CoalTrain59/CandleStick/CandleStick_Board_Rev1/HelpLinks.txt

https://www.circuitbasics.com/arduino-thermistor-temperature-sensor-tutorial/
