CoalTrain59/CandleStick/CandleBurner/BOM.txt

ID	Name	Quantity	Manufacturer Part	Manufacturer	Supplier	Supplier Part	Price
1	100Ω	1	201007F1000T4E	Uniroyal Elec	LCSC	C421954	0.024
2	VA05-V2S12	1	VA05-V2S12	GTL-POWER	LCSC	C341500	5.303
3	DB128L-5.0-2P-BK-S	2	DB128L-5.0-2P-BK-S	DIBO	LCSC	C430597	0.136
4	KH-A2541WV-6P	1	KH-A2541WV-6P	kinghelm(金航标)	LCSC	C2833331	0.141
5	0.47uF	3	KMR47M050C110A	Capxon International Elec	LCSC	C244347	0.021
6	KH-A2541WV-10P	1	KH-A2541WV-10P	kinghelm(金航标)	LCSC	C2833333	0.229
7	220S-1*8P H=8.5MM Ytype Gold-plated	1	220S-1*8P H=8.5MM Ytype Gold-plated	Ckmtw	LCSC	C124416	0.13
8	TLP521-1XSM	1	TLP521-1XSM	ISOCOM	LCSC	C83157	0.174
9	KH-A2541WV-8P	2	KH-A2541WV-8P	kinghelm(金航标)	LCSC	C2833332	0.183
10	1kΩ	7	RT2010BKE071KL	YAGEO	LCSC	C706458	0.105
11	10kΩ	1	201007F1002T4E	Uniroyal Elec	LCSC	C421952	0.024
12	DB107S_C5377	1	DB107S	MDD	LCSC	C5377	0.064
13	220S-2*3P H=8.5MM Ytype Gold-plated	1	220S-2*3P H=8.5MM Ytype Gold-plated	Ckmtw	LCSC	C124421	0.113
14	BTA08-600CRG	1	BTA08-600CRG	STMicroelectronics	LCSC	C9102	0.83
15	MOC3020	1	MOC3020	LITEON	LCSC	C115463	0.191
