CoalTrain59/CandleStick/Enclosure/MainLid.stl

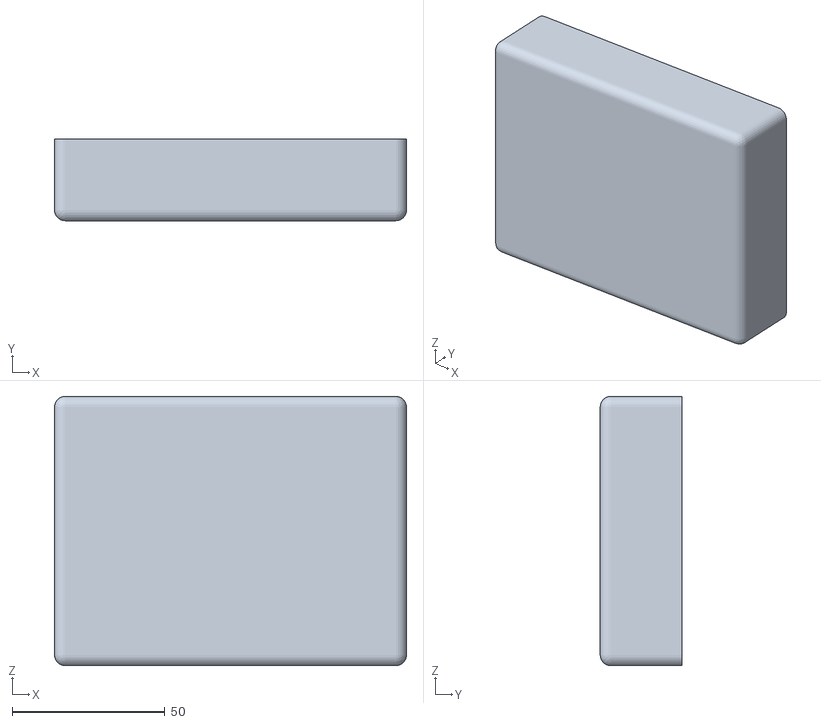
[picture p1: CAD file, 2022-04-02]
Enclosure/MainLid.stl
115.4 x 26.8 x 88.3
