CoalTrain59/CandleStick/Enclosure/CandleBurnerEnclosure.FCStd

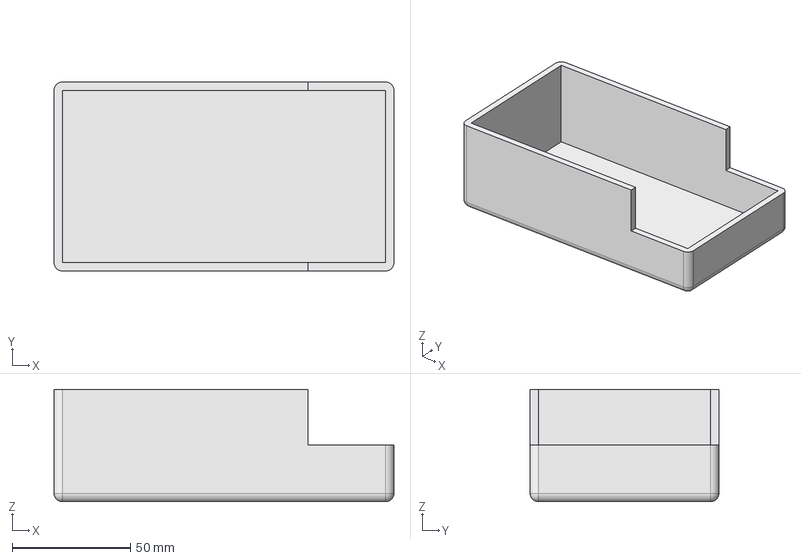
[picture p2: CAD file, 2022-04-02]
Enclosure/CandleBurnerEnclosure.FCStd
144.0 x 80.0 x 47.5 mm
