CoalTrain59/CandleStick/(list of files, cad)

Other CAD files:
Enclosure/CandleBurnerLid.FCStd
Enclosure/Enclosure1.stl
