CoalTrain59/CandleStick/PID Tuning/Best.png

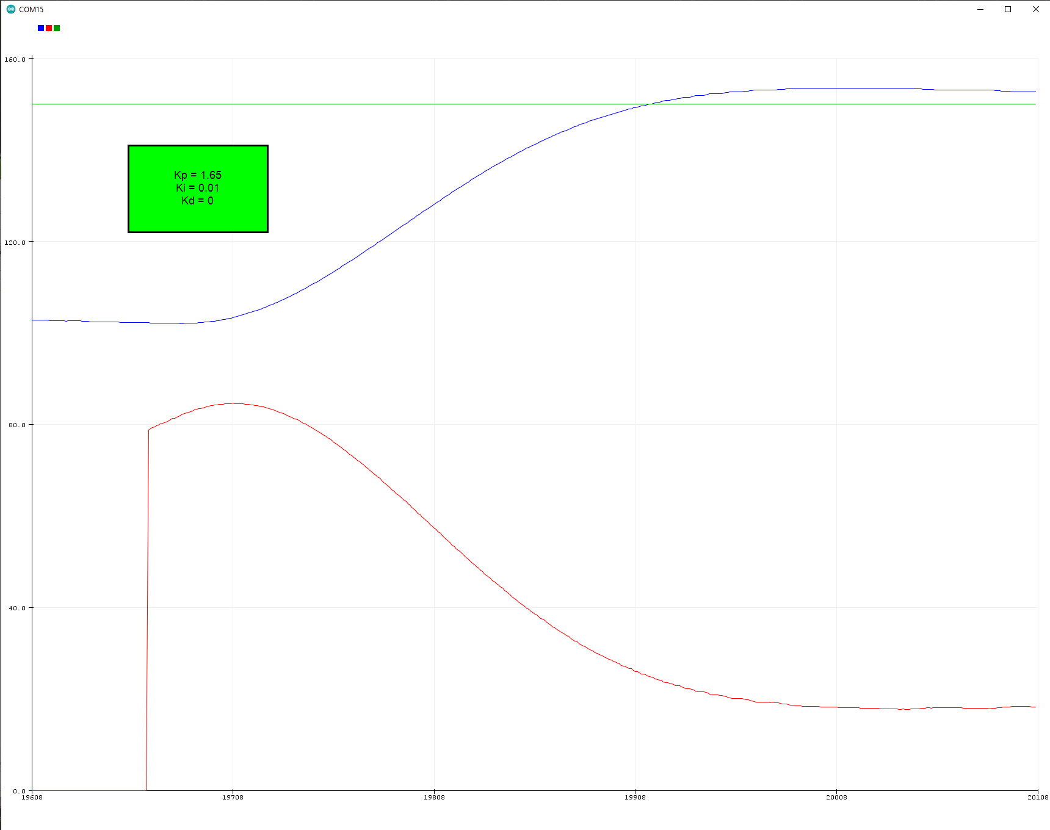
PID Tuning/Best.png
