CoalTrain59/CandleStick/PID Tuning/Better.png

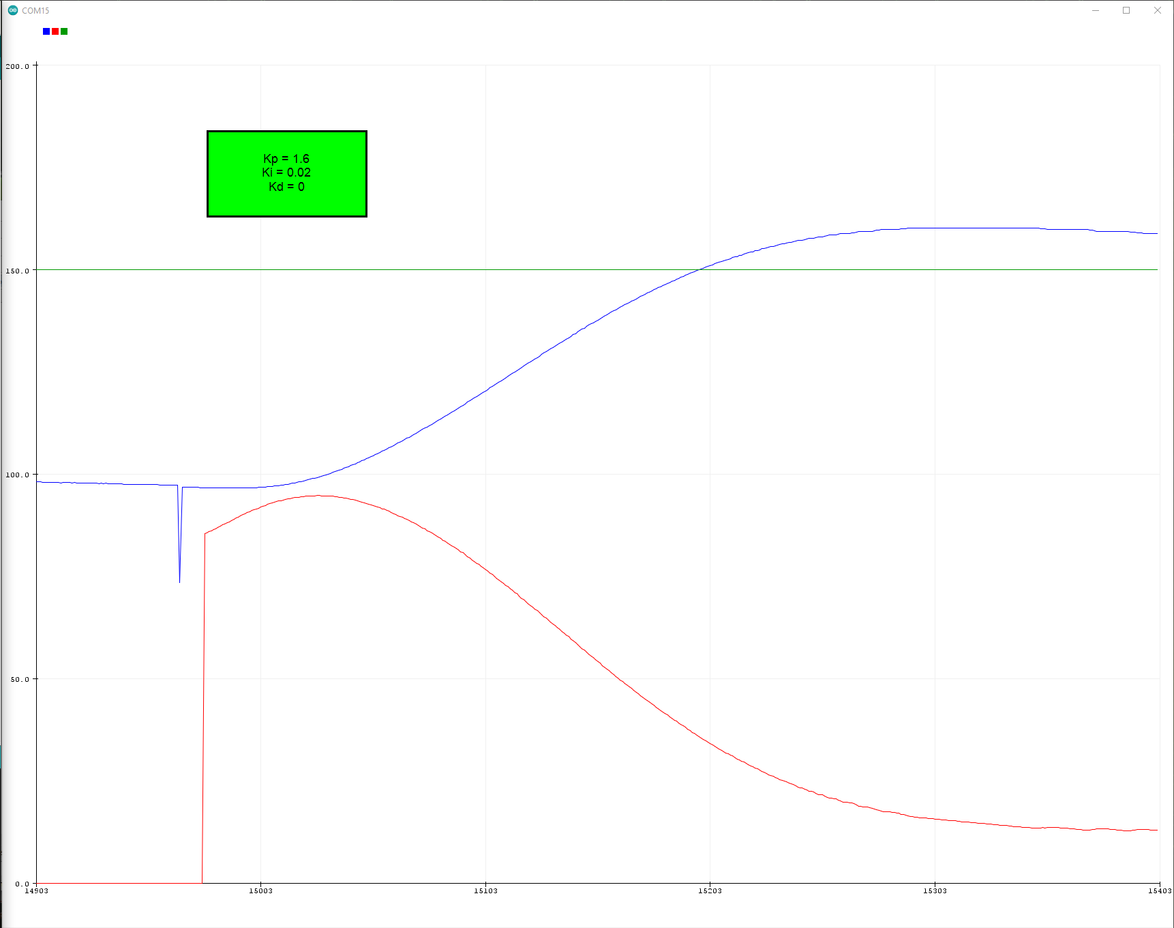
PID Tuning/Better.png
