CoalTrain59/CandleStick/PID Tuning/Test1.png

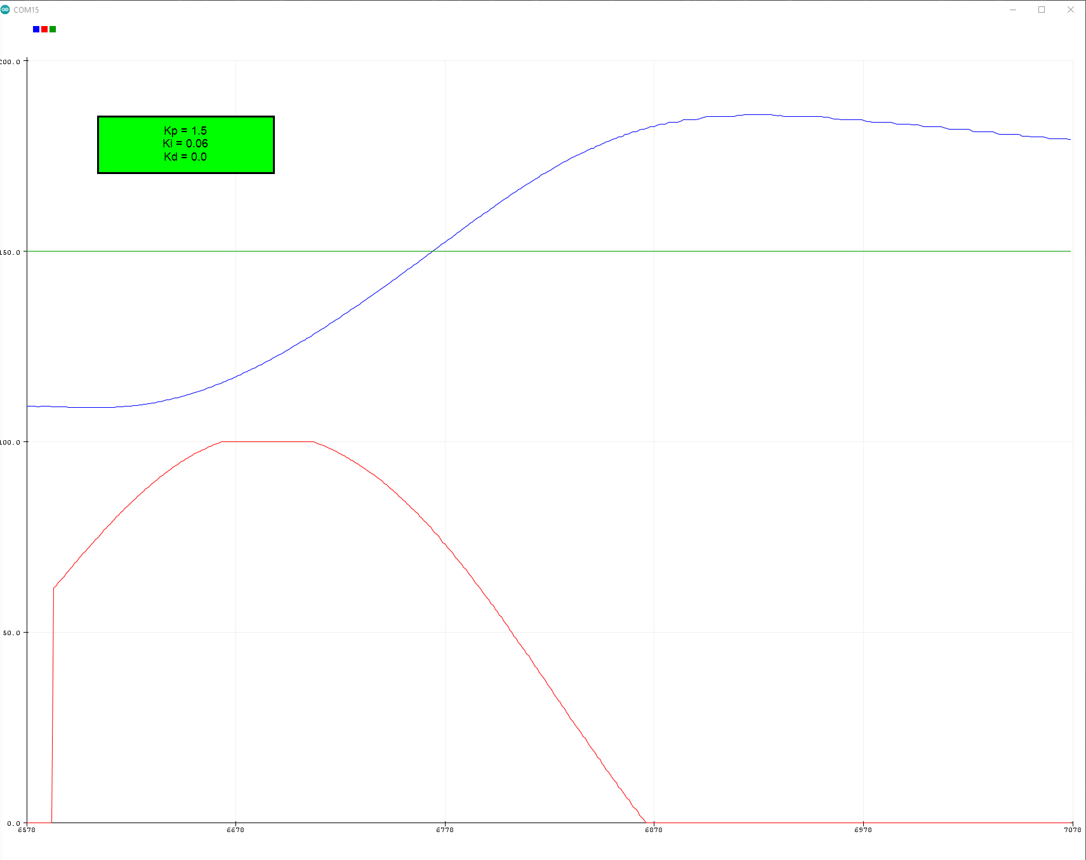
PID Tuning/Test1.png
