CoalTrain59/CandleStick/(threads)

Thread 5 (2022-06-14):

Runaway Logic

CoalTrain59, 2022-06-14:
Need to provide logic for situation of a failed thermistor / poor connection.
-If the thermistor input is outside of an obvious temperature range, disable the system and log an error. "Therm ERR"
-If the PID output is on and the input temperature is not within tolerance of setpoint within 45 seconds, disable output & throw error. "Low Tmp Err"

CoalTrain59, 2022-06-18:
Did not implement 45 second timer. Do not see this being a problem as long as therm has a good reading should be OK.

Closed 2022-06-18.

Thread 9 (2022-06-18):

Redraw causes Running! to disappear

CoalTrain59, 2022-06-18:
When redrawing on the timer, if Running! it resets to "run"

Closed 2022-06-18.

Thread 13 (2022-06-19):

RTD Circuitry needs added to board

CoalTrain59, 2022-06-19:
Never accounted for RTD input circuit to board. Update the board to incorporate this input.

CoalTrain59, 2022-06-19:
FYI - the Circuitry goes into pin A3 for the software (double check this, but I'm pretty sure). 5V goes to a 10K resistor, then to the Thermistor to ground. The A3 Wire reads voltage from thermistor to ground.

Thread 14 (2022-06-19):

Pin Spacing incorrect for Arduino Uno

CoalTrain59, 2022-06-19:
Pin spacing incorrect for Arduino Uno. Fix spacing on PCB Layout
