CoalTrain59/CandleStick/(commit log)

2022-04-02 Fried the Board. Software seems good so far
2022-06-12 Fix Temperature Logging Timing To Not Effect TRIAC Output
    [CandleStick_Board_Rev1.ino]
2022-06-13 Fix Temperature Issues
    [Calculations.xlsx]
2022-06-14 PID Implemented, commence tuning. Tuning Close
2022-06-14 Final PID values. Not perfect but good
2022-06-18 Add setpoint & current temp to display
2022-06-18 Implement believable temperature range check
2022-06-18 Fix redraw. Remove printing false information on startup. Wait for first 10 second update before screen appears
    [CL_Defines.h, CandleStick_Board_Rev1.ino]
2022-06-18 Fix screen updating. Issue was with state
    [CandleStick_Board_Rev1.ino]
2022-07-02 Add PCB Backup Files from EASY EDA
